varunpandey0502/robot_dog/step/UpperIn_FL.step

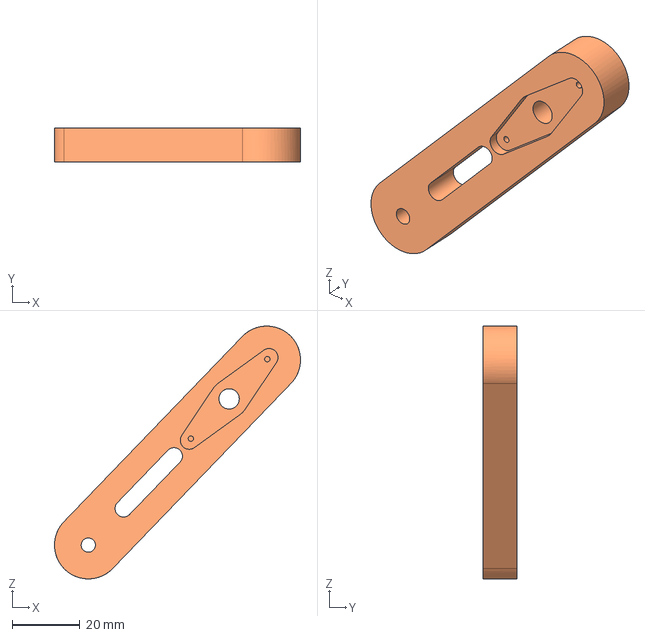
[picture p2: CAD file, 2026-11-08]
step/UpperIn_FL.step
72.7 x 10.00 x 74.7 mm
