varunpandey0502/robot_dog/step/LowerIn_FR.step

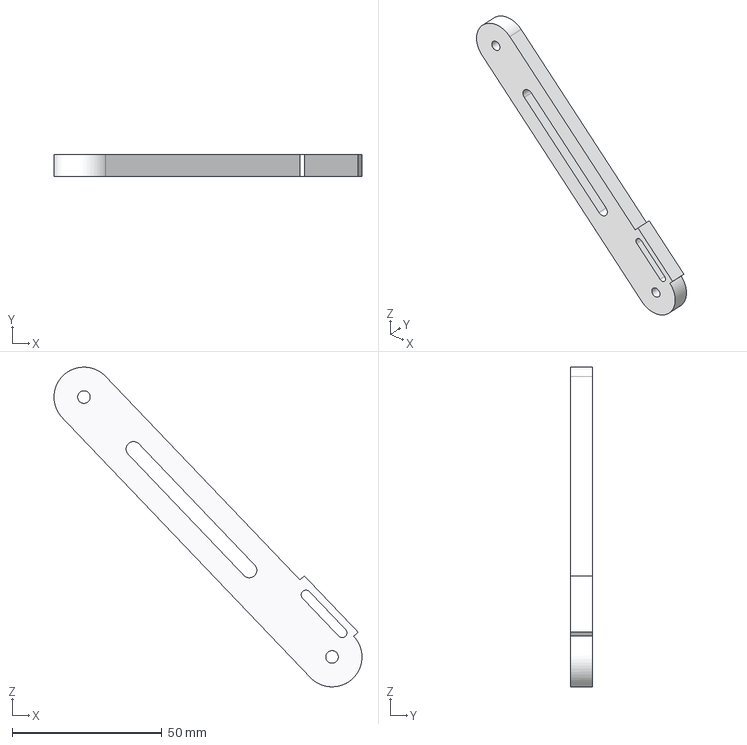
[picture p3: CAD file, 2026-11-08]
step/LowerIn_FR.step
102.9 x 7.50 x 106.8 mm
