varunpandey0502/robot_dog/step/FootBoot_RR_TPU.step

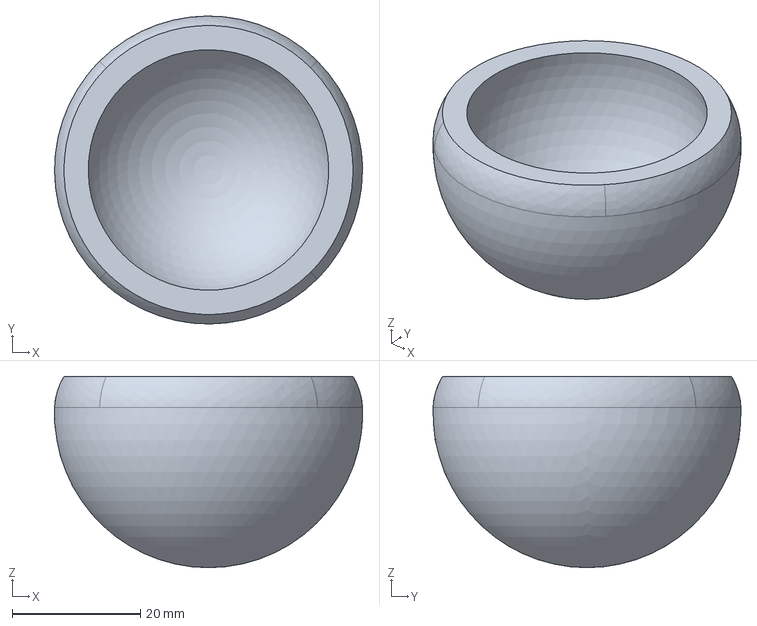
[picture p4: CAD file, 2026-11-08]
step/FootBoot_RR_TPU.step
48.0 x 48.0 x 29.8 mm
