varunpandey0502/robot_dog/step/Foot_RL.step

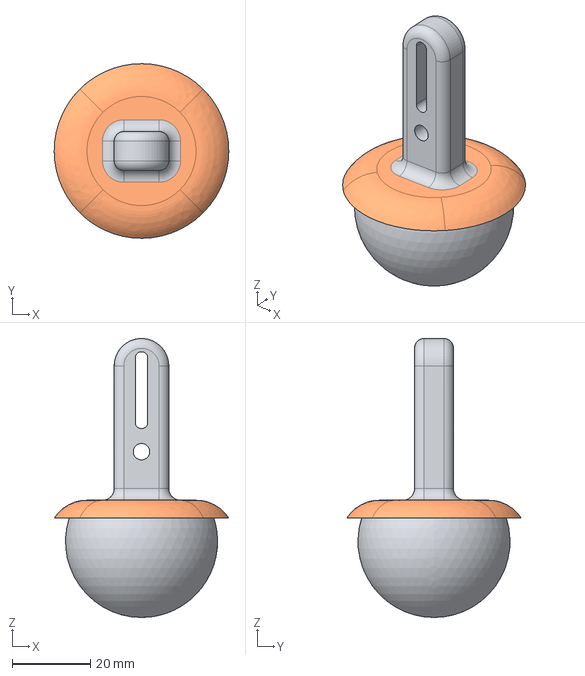
[picture p5: CAD file, 2026-11-08]
step/Foot_RL.step
44.8 x 44.8 x 71.5 mm
