varunpandey0502/robot_dog/step/LowerOut_RR.step

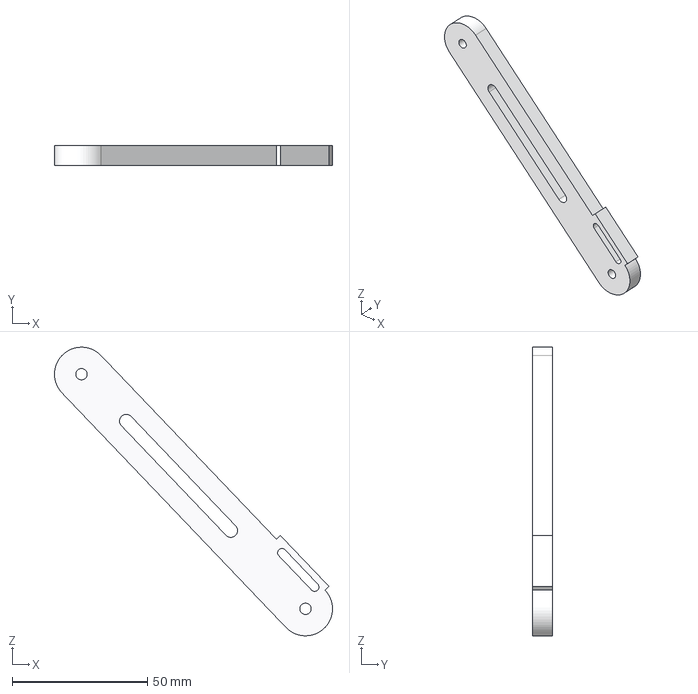
[picture p6: CAD file, 2026-11-08]
step/LowerOut_RR.step
102.8 x 7.50 x 106.8 mm
