varunpandey0502/robot_dog/step/BarRear.step

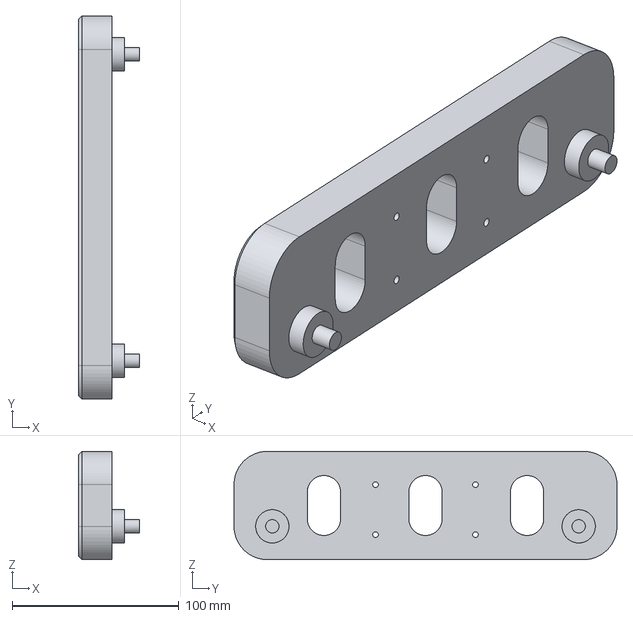
[picture p7: CAD file, 2026-11-08]
step/BarRear.step
36.5 x 230.0 x 65.0 mm
