varunpandey0502/robot_dog/step/Coxa_FL.step

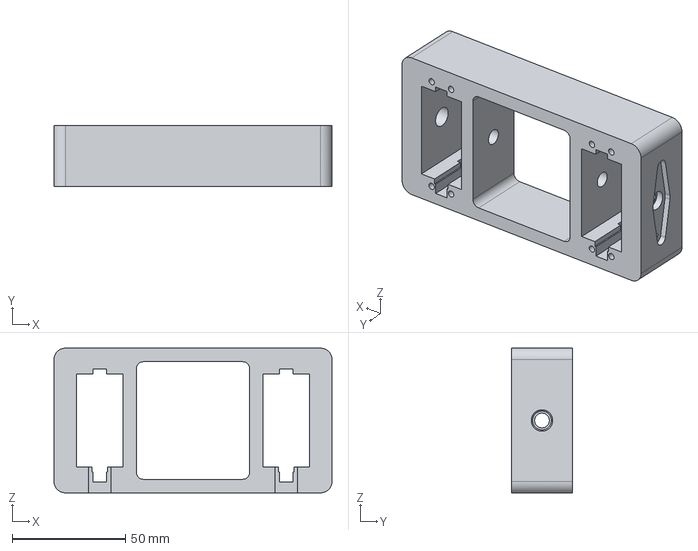
[picture p8: CAD file, 2026-11-08]
step/Coxa_FL.step
123.0 x 27.0 x 64.0 mm
