varunpandey0502/robot_dog/step/Handle.step

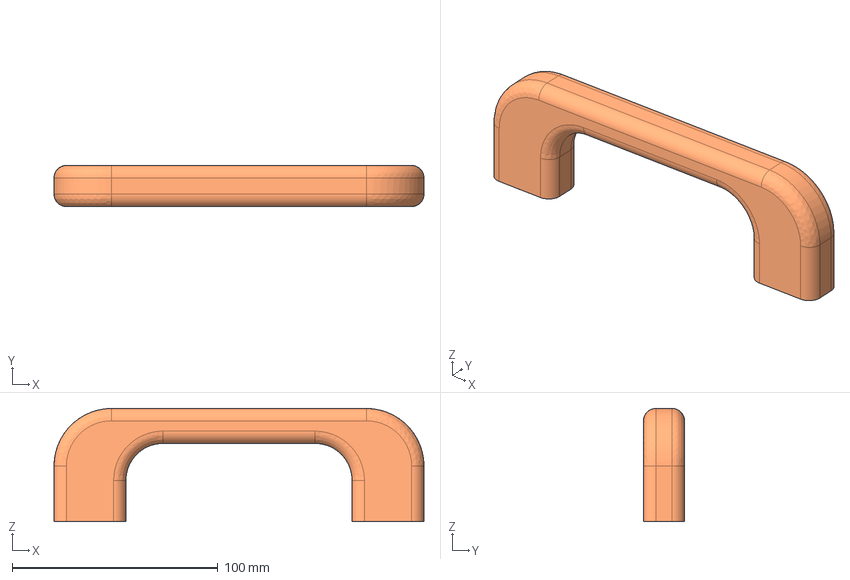
[picture p9: CAD file, 2026-11-08]
step/Handle.step
180.0 x 20.0 x 55.0 mm
