varunpandey0502/robot_dog/step/TopPlate.step

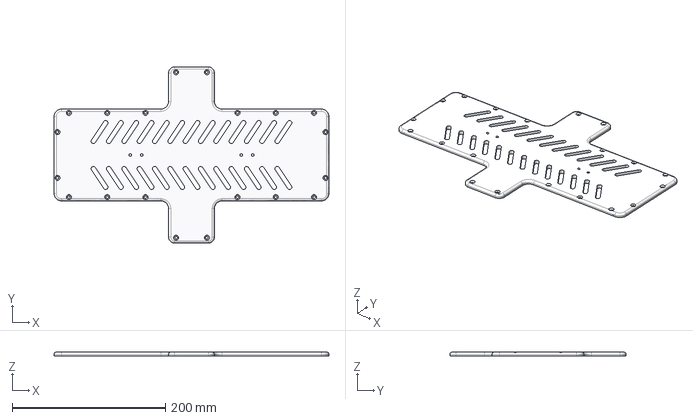
[picture p10: CAD file, 2026-11-08]
step/TopPlate.step
359.0 x 230.0 x 5.00 mm
