varunpandey0502/robot_dog/step/Chassis.step

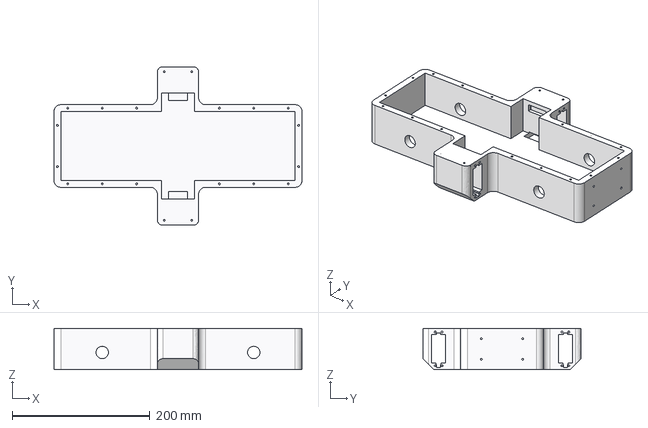
[picture p11: CAD file, 2026-11-08]
step/Chassis.step
360.0 x 230.0 x 60.0 mm
