varunpandey0502/robot_dog/(list of files, cad)

Other CAD files:
step/UpperOut_FR.step
step/UpperOut_RL.step
step/FootBoot_FR_TPU.step
step/LowerIn_RL.step
step/LowerIn_RR.step
step/Coxa_RL.step
step/BarFront.step
step/Foot_FL.step
step/UpperOut_FL.step
step/FootBoot_FL_TPU.step
step/LowerOut_FL.step
step/Foot_FR.step
step/UpperIn_RR.step
step/LowerIn_FL.step
step/Foot_RR.step
step/UpperIn_FR.step
step/UpperOut_RR.step
step/LowerOut_FR.step
step/FootBoot_RL_TPU.step
step/LowerOut_RL.step
step/Coxa_FR.step
step/UpperIn_RL.step
step/Coxa_RR.step
stl/BarFront.stl
stl/BarRear.stl
stl/Chassis.stl
stl/Coxa_FL.stl
stl/Coxa_FR.stl
stl/Coxa_RL.stl
stl/Coxa_RR.stl
stl/FootBoot_FL_TPU.stl
stl/FootBoot_FR_TPU.stl
stl/FootBoot_RL_TPU.stl
stl/FootBoot_RR_TPU.stl
stl/Foot_FL.stl
stl/Foot_FR.stl
stl/Foot_RL.stl
stl/Foot_RR.stl
stl/Handle.stl
stl/LowerIn_FL.stl
stl/LowerIn_FR.stl
stl/LowerIn_RL.stl
stl/LowerIn_RR.stl
stl/LowerOut_FL.stl
stl/LowerOut_FR.stl
stl/LowerOut_RL.stl
stl/LowerOut_RR.stl
stl/TopPlate.stl
stl/UpperIn_FL.stl
stl/UpperIn_FR.stl
stl/UpperIn_RL.stl
stl/UpperIn_RR.stl
stl/UpperOut_FL.stl
stl/UpperOut_FR.stl
stl/UpperOut_RL.stl
stl/UpperOut_RR.stl
