varunpandey0502/robot_dog/(commit log)

2026-11-08 Add MG996R robot dog design and printable STLs
    SolidCraft assembly (v8) and one STL per printed part.
    [BarFront.stl, BarRear.stl, Chassis.stl, Coxa_FL.stl, Coxa_FR.stl, Coxa_RL.stl, Coxa_RR.stl, FootBoot_FL_TPU.stl]
2026-11-08 Organize files into folders and add docs and STEP exports
    Move STL and SolidCraft files into stl/ and solidcraft/, add a STEP
    export of each printed part in step/, and add a README, BOM and render.
    [BarFront.step, BarFront.stl, BarRear.step, BarRear.stl, Chassis.step, Chassis.stl, Coxa_FL.step, Coxa_FL.stl]
